adafruit/Adafruit-LIS331-PCB/Adafruit_LIS331.brd

## EAGLE design Adafruit_LIS331.brd (2020-05-14)

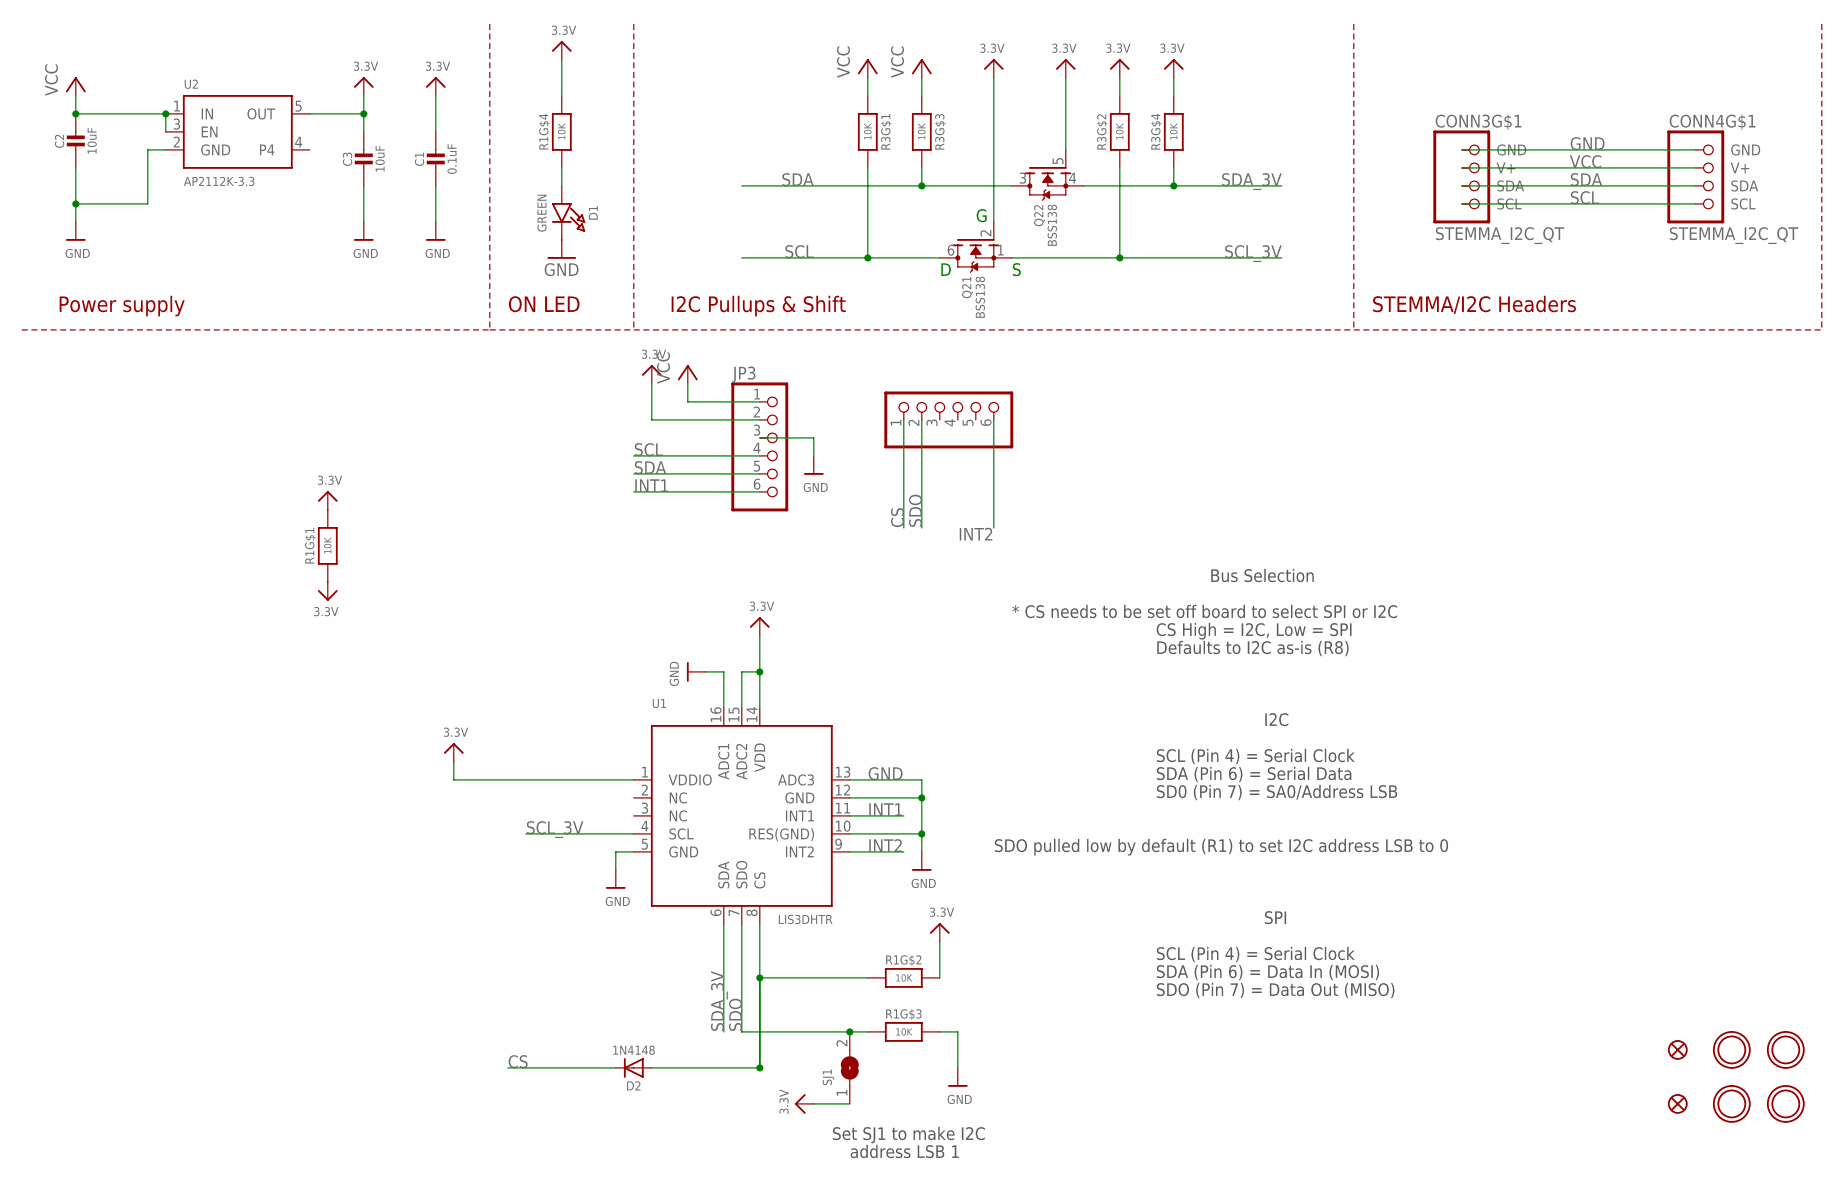
[picture p2: schematic Adafruit_LIS331.sch]

Parts:
C1: 0.1uF; 0603-NO
C2, C3: 10uF; 0805-NO
CONN3, CONN4: STEMMA_I2C_QT; JST_SH4
D1: GREEN; CHIPLED_0603_NOOUTLINE
D2: 1N4148; SOD-323
FID3, FID4: FIDUCIAL_1MM
JP2, JP3: HEADER-1X670MIL; 1X06_ROUND_70
Q2: BSS138; SOT363
R1, R3: 10K; RESPACK_4X0603
SJ1: SOLDERJUMPER; SOLDERJUMPER_ARROW_NOPASTE
U1: LIS3DHTR; LGA16_3X3MM
U2: AP2112K-3.3; SOT23-5
U$1, U$17, U$19, U$21: MOUNTINGHOLE2.5; MOUNTINGHOLE_2.5_PLATED

Connections:
3.3V: C1.1, C3.1, JP3.2, Q2.2 (G), Q2.5 (G), R1.1, R1.5 (2), R1.7 (2), R1.8 (2), R3.2 (1), R3.4 (1), SJ1.1, U1.1 (VDDIO), U1.14 (VDD), U1.15 (ADC2), U2.5 (OUT)
CS: D2.C, JP2.1
GND: C1.2, C2.2, C3.2, CONN3.1 (GND), CONN4.1 (GND), D1.C, JP3.3, R1.6 (2), U1.5 (GND), U1.10 (RES(GND)), U1.12 (GND), U1.13 (ADC3), U1.16 (ADC1), U2.2 (GND)
INT1: JP3.6, U1.11 (INT1)
INT2: JP2.6, U1.9 (INT2)
unnamed: D1.A, R1.4 (1)
unnamed: D2.A, R1.2 (1), U1.8 (CS)
SCL: CONN3.4 (SCL), CONN4.4 (SCL), JP3.4, Q2.6 (D), R3.8 (2)
SCL_3V: Q2.1 (S), R3.7 (2), U1.4 (SCL)
SDA: CONN3.3 (SDA), CONN4.3 (SDA), JP3.5, Q2.3 (D), R3.6 (2)
SDA_3V: Q2.4 (S), R3.5 (2), U1.6 (SDA)
SDO: JP2.2, R1.3 (1), SJ1.2, U1.7 (SDO)
VCC: C2.1, CONN3.2 (V+), CONN4.2 (V+), JP3.1, R3.1, R3.3 (1), U2.1 (IN), U2.3 (EN)

Notes on the sheet:
I2C Pullups & Shift
STEMMA/I2C Headers
ON LED
Power supply
I2C
SCL (Pin 4) = Serial Clock
SDA (Pin 6) = Serial Data
SD0 (Pin 7) = SA0/Address LSB
* CS needs to be set off board to select SPI or I2C
CS High = I2C, Low = SPI
Defaults to I2C as-is (R8)
SDO pulled low by default (R1) to set I2C address LSB to 0
Bus Selection
SPI
SDA (Pin 6) = Data In (MOSI)
SDO (Pin 7) = Data Out (MISO)
Set SJ1 to make I2C
address LSB 1

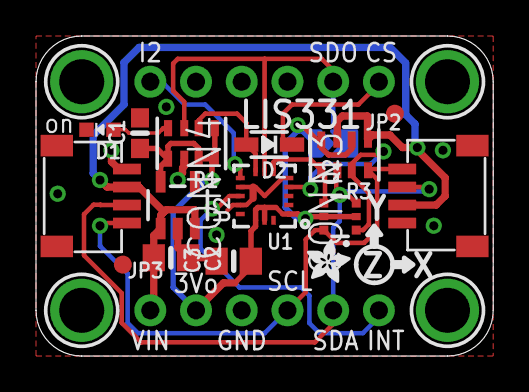
[picture p3: board Adafruit_LIS331.brd from above]

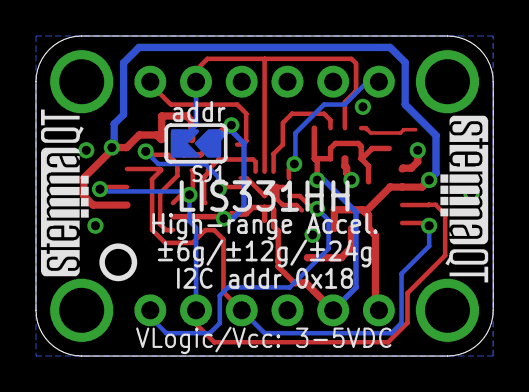
[picture p4: board Adafruit_LIS331.brd from below]

Board: 2 copper layers, 25.4 x 17.8 mm, 25 parts (4 on the bottom side), 13 nets.

Other parts of the board:
U$12: ADAFRUIT_2.5MM
U$25: PCBFEAT-REV-040
U$30, U$31: STEMMAQT
